shyul/pmu/design/schematic.png

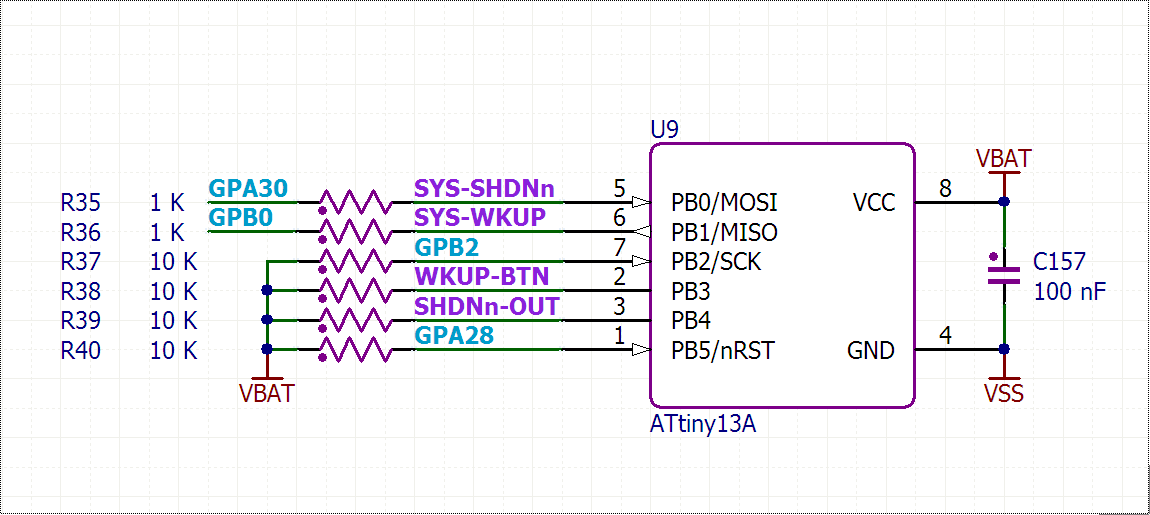
design/schematic.png
